ZackHirshhorn/sv08-fan-holder/sv08_5020_fan_holder.step

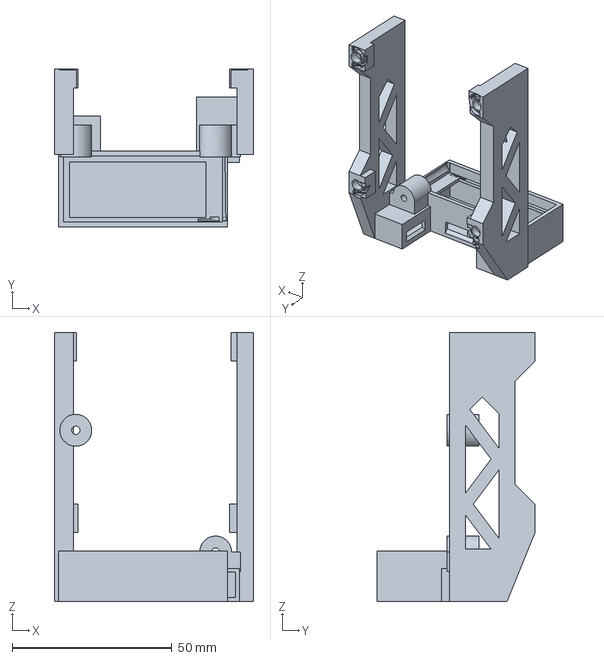
[picture p2: CAD file, 2026-10-27]
sv08_5020_fan_holder.step
62.5 x 49.5 x 84.3 mm
