ZackHirshhorn/sv08-fan-holder/(list of files, cad)

Other CAD files:
sv08_5020_fan_holder.stl
