ZackHirshhorn/sv08-fan-holder/(commit log)

2026-10-27 Minimal 5020 fan holder and duct for the Sovol SV08
    Claude-Session: https://claude.ai/code/session_01DdAMsak2cKDqjc9CoktGoj
    [sv08_5020_fan_holder.step, sv08_5020_fan_holder.stl]
2026-10-27 Strengthen frame with deep side cheeks
    Replace the 5x6 mm rails and side braces with 21 mm deep YZ cheeks that
    run from the duct floor to the upper magnet pads, using the empty space
    between the 5020 and the extruder plate. Front/back flanges with diagonal
    ribs make them ~10x stiffer against magnet pull-off and ~2.5x sideways.
    The upper-left fan boss now merges into the left cheek, and both bosses
    grow to 10 mm. Clearance re-checked against the full stock hotend STEP.
    Also add requirements.txt and .gitignore for a Python 3.13 venv
    (cadquery-ocp has no 3.14 wheels yet).
    [sv08_5020_fan_holder.step, sv08_5020_fan_holder.stl]
